sageshoyu/docs-opmanual_sky/README.md

This repository is a duckuments book. 

Please see the repository [docs-duckumentation](https://github.com/duckietown/docs-duckumentation)
for instructions on how to compile this book, and use that repository for filing issues.
