sageshoyu/docs-opmanual_sky/book/opmanual_sky/100-build/101-overview.md

# Build {#part:build status=ready}

This section describes how to build the DuckieSky Drone Version 4. You
will need: 
- a drone kit
- a base station (i.e. personal computer)
- access to a lab, Maker, or Hacker space
- a highly-textured planar surface (e.g. poster board with many random hand-drawn figures)
