sageshoyu/docs-opmanual_sky/(list of files, cad)

Other CAD files:
book/opmanual_sky/100-build/PiMount V2 (1) (1).stl
