sageshoyu/docs-opmanual_sky/book/opmanual_sky/100-build/106-phase1-establish_power_distribution.md

# Establish Power Distribution {#part:build-assignment-5 status=ready}
