sageshoyu/docs-opmanual_sky/book/opmanual_sky/100-build/107-phase2-attach_sensors.md

# Attach Sensors {#part:build-assignment-6 status=ready}
