sageshoyu/docs-opmanual_sky/book/opmanual_sky/100-build/108-phase3-configure_devices.md

# Configure Devices {#part:build-assignment-7 status=ready}
