sageshoyu/docs-opmanual_sky/book/opmanual_sky/100-build/109-phase4-finalize_assembly.md

# Finalize Assembly {#part:build-assignment-8 status=ready}
