sageshoyu/docs-opmanual_sky/book/opmanual_sky/100-build/ESCSetup_DEPREACATED.md

# ESC Setup {status=draft}
The Afro ESC (electronic speed controller) stock firmware is called SimonK. In testing we found that the throttle response time for our ESCs on this firmware was not quick enough, and this would cause adverse flight effects during aggressive maneuvers.

During this step you will reflash your ESCs with an alternative open-source firmware called BLHeli, which is has a faster response time and a convenient GUI for ESC configuration. The BLHeli firmware can only be flashed on Windows. If you do not have Windows, please come to office hours, where we have computers setup to flash BLHeli.

## Flashing ESCs
Make sure you have no propellers on your motors. For each ESC:

1) Plug in the battery to your drone

2) Plug the ESC into the flashing tool. Pay careful attention that the yellow wire goes to s (signal) and the brown wire goes to - (ground).

<figure>
    <figcaption>Plug ESC into Flashing Tool</figcaption>
    
</figure>
<figure>
    <figcaption>Plug ESC into Flashing Tool</figcaption>
    
</figure>

3) Click the "Connect" button in BlHeliSuite
<figure>
    <figcaption>Connect</figcaption>
    
</figure>

4) Click the read setup button
<figure>
    <figcaption>Read Setup</figcaption>
    
</figure>

5) When prompted to flash your ESC, click "Yes"
<figure>
    <figcaption>Flash your ESC</figcaption>
    
</figure>

6) You will be presented with a list of ESC firmwares. Select Afro 20A Multi from the list and click OK.
<figure>
    <figcaption>Select Firmware</figcaption>
    
</figure>

7) Confirm that you want to flash your ESC
<figure>
    <figcaption>Confirm</figcaption>
    
</figure>

<figure>
    <figcaption>Flashing</figcaption>
    
</figure>

8) When finished, a window will appear, notifying you that the ESC has properly been flashed. If there are any errors, call over a TA. Click "OK" to dismiss the window.
<figure>
    <figcaption>Finish Flashing</figcaption>
    
</figure>

9) A window will appear notifying you that the ESC setup has been read successfully. Click "OK".
<figure>
    <figcaption>Done!</figcaption>
    
</figure>

10) Change the "PPM Min Throttle" 1100 and the "PPM Max Throttle" to 1900.
<figure>
    <figcaption>Throttle Config</figcaption>
    
</figure>

If this was one of the motors for which you needed to change the direction in the previous section, change the 'Motor Direction' parameter accordingly.
<figure>
    <figcaption>Correct Motor Directions</figcaption>
    
</figure>

11) Lastly turn off the beacon setting. To do this set it to infinite. This prevents the motors from beeping if the flight controller is plugged in but not receiving controls.
12)
<figure>
    <figcaption>Beacon Setting</figcaption>
    
</figure>

12) Write these changes to the ESC.
<figure>
    <figcaption>Save Changes to ESC</figcaption>
    
</figure>

13) Repeat until all ESCs are flashed.

## Checkoff
Come to TA hours to get checked off! We will check that you have **all four** motors flashed, spinning the right direction, and connected to your flight controller correctly.
