sageshoyu/docs-opmanual_sky/book/opmanual_sky/100-build/FlightControllerSetup_DEPREACATED.md

# Cleanflight on the Skyline 32 {status=draft}

The Skyline 32 is the flight controller; it has an onboard accelerometer and gyroscope, and sends commands to the ESCs. We compile the firmware (called CleanFlight) with an option that allows us to control the Skyline via USB. In this part, you will mount and configure the Skyline 32, install new firmware on it, and power up the motors!

## Mounting the Flight Controller
Plug the voltage monitoring cable (now soldered to your BEC) and the 6-channel PWM cable into your skyline

<figure>
    <figcaption>Plug in Skyline Cables</figcaption>
    
</figure>

Use double-sided foam tape to mount the skyline to the front of your drone. The USB port should be facing forward, so you have access to it. Also run the PWM connectors underneath the pi mount for easier wire management later.

<figure>
    <figcaption>Skyline Top View</figcaption>
    
</figure>

It is very important that the flight controller is perfectly aligned with your drone's frame. Any misalignments will mean that the sensors are getting incorrect (coupled axes) information about the acceleration. Make sure the edge of the flight controller is parallel with the edge of the frame.

<figure>
    <figcaption>Skyline Bottom View</figcaption>
    
</figure>

Carefully plug the 6" USB cable into the USB port of the skyline. These little surface-mount USB micro ports are very prone to failure, so to minimize the likelyhood of ripping off the port or breaking a connection cover the USB connector thoroughly with hot glue. Yes, you will not be able to remove the USB cable. This is intentional.

<figure>
    <figcaption>Glued USB Connector</figcaption>
    
</figure>

## Compiling Firmware For Skyline32
Download the [pre-compiled hex](https://cs.brown.edu/courses/cs1951r/website_2017/projects/build/cleanflight_2.1.0_NAZE.hex).

You can also recompile the firmware. To do this, download the firmware source code at https://github.com/cleanflight/cleanflight and compile with

    make arm_sdk_install

    make NAZE OPTIONS=USE_MSP_UART

## Flashing Fimware
You will now flash the firmware onto the flight controller.

*Note: in order to use cleanflight on your personal computer rather than base station in the lab see cleanflight homepage for driver installation.*

1. Plug the skyline into the computer via USB. If your skyline is already on a drone, do not connect the battery.
2. Open [cleanflight configurator](https://chrome.google.com/webstore/detail/cleanflight-configurator/enacoimjcgeinfnnnpajinjgmkahmfgb) and go to the "Firmware Flasher" tab. This tab is before you connect to the base station.

<figure>
    <figcaption>Firmware Flasher</figcaption>
    
</figure>

3. Click "Load Firmware [local]" and load your custom firmware file.

<figure>
    <figcaption>Load Firmware</figcaption>
    
</figure>

4. Click the "Flash Firmware" button to flash the flight controller.

<figure>
    <figcaption>Flash Firmware</figcaption>
    
</figure>

5. If this is a success, the bar at the bottom will say "Programming: SUCCESSFUL" and you are ready to move to the next step.
<figure>
    <figcaption>Success!</figcaption>
    
</figure>

## Configuration Options
You will configure the flight controller based on our drone's specific geometry and hardware.

1. Plug in Skyline and click "Connect"
<figure>
    <figcaption>Connect to Skyline</figcaption>
    
</figure>
2. Go to "Ports" tab and make sure SerialRX for UART2 is disabled and click "Save and Reboot." UART2 is a pin on the flight controller, and we want to make sure it only uses the USB.
<figure>
    <figcaption>Ports Config</figcaption>
    
</figure>

3. Go to "Configuration" tab
4.
i. Flip the yaw by 180 degrees and click "Save and Reboot." This is because we mount the flight controller the opposite direction in order to leave the USB port free to plug into the Raspberry Pi.
<figure>
    <figcaption>Flip Yaw</figcaption>
    
</figure>
ii. Also change the receiver to "MSP RX input" and click "Save and Reboot." By default it is configured to receive data from an RC receiver, but we want it to take commands over MSP.
<figure>
    <figcaption>MSP RX Input</figcaption>
    
</figure>
iii. Set the Minimum Throttle to 1100.
4. We need tell it to be in Angle mode for the entire range (and not acrobatic mode). Go to the "Modes" tab
i. Under "Angle", click "Add Range."
<figure>
    <figcaption>Angle Mode</figcaption>
    
</figure>
ii. Drag the sliders so that the range spans from 900 to 2100. (The entire range.)
<figure>
    <figcaption>Expand Range</figcaption>
    
</figure>
<figure>
    <figcaption>Expanded Angle Range</figcaption>
    
</figure>

iii. Click "Save".

5.We need to change the PID parameters to ones that work better on our drone. Go to the "PID Tuning" tab.
i. Change the "ROLL" and "PITCH" PID terms to match the image. Roll should be (Proportional: 60, Integral: 40, Derivative: 50, RC Rate: 1.00, Super Rate: 0.00, Max Vel: 200). Pitch should be (Proportional: 60, Integral: 40, Derivative: 50, RC Rate: curly bracket, Super Rate: 0.00, Max Vel: 200)
<figure>
    <figcaption>PID Params</figcaption>
    
</figure>
ii. Change angle limit to 50.
<figure>
    <figcaption>Angle Limit</figcaption>
    
</figure>
iii. Click "Save."

## Plug in the motors
The numbers corresponding to each motor are as shown. Recall that the camera is in the back of the frame and the flight controller is in the front.
<figure>
    <figcaption>Motor Numbers</figcaption>
    
</figure>
The yellow cable coming out of the skyline has 6 numbered connectors. Plug each motor into the corresponding connector (1-4) according to the above numbering scheme. The connectors shouldn't be too easy to plug in backwards, but make sure the yellow wire from the motor goes to the yellow wire in the connector from the skyline. The other 2 wires PWM 5/6 can be cut off.
<figure>
    <figcaption>Connecting PWM Wires</figcaption>
    
</figure>

## Test the motors
This is the first time you will be firing up your drone! At this point, make sure there is nothing that could be potentially causing a short on your PDB. Take a battery and plug it into the XT60 connector. If you did everything right, lights should come on and the motors beep. If this doesn’t happen, unplug the battery **immediately**! It is likely the case that something is backwards or shorting, and you could be causing damage by applying a voltage.

Now plug in the Skyline to your computer via USB and connect to the Cleanflight configurator.

i. Go to the Motors tab in Cleanflight. Make sure the props are off!
ii. Read the safety notice and check the box that says “I understand the risks, propellers are removed - Enable motor control.”
iii. Slowly power up each motor. Verify first that the correct motor spins and second that it spins in the correct direction using the diagram below.
iv. If the motor does not spin, verify the connections, make sure there are no shorts and that it has power.
v. If the motor spins in the wrong direction, make a note of which motor it is. You will be able to flip the directions of motors that are spinning the wrong way in the next section.

<figure>
    <figcaption>Correct Motor Directions</figcaption>
    
</figure>

## Calibrate your ESCs

This configuration tells the ESC at what PWM to start spinning up the
motor.  If you do not do it, the ESCs will not all work together to
allow the drone to fly stably.  Symptons that this needs to be done
include hot motors, a drone that lists to one side, or motors that
appear to spin at different speeds.

There appears to be a software bug in Cleanflight that causes this
calibration process to switch the motor directions, so make sure you
follow all steps and make sure the motors are spinning in the right
direction when you finish.

1. REMOVE ALL PROPELLERS.
1. Connect the flight controller to computer, then open up CleanFlight.
1. Go to Motors tab.
1. Unplug the battery from the drone.
1. Toggle on "Motor Test Mode Notice". MAKE SURE ALL PROPELLERS REMOVED!
1. Drag master slider up to full. All 4 motor sliders should move up to full accordingly (i.e. 2000).
1. Plug the battery into the drone
1. ESCs will make an interesting set of sounds, kind of like music.  If they do not, stop and try the previous steps again.
1. After the music stops, click on the bottom end of the master slider bar. The master slider should now be at the bottom of the bar. Correspondingly, all 4 motor sliders should be at the bottoms of their bars (i.e. 1000).
1.. The motors will make another set of sounds. 
1. After the sounds stop, spin up each motor one at a time. Make sure they are spinning in the right direction (i.e. according to the diagram).  
1. Go to the Configuration tab. If the drone diagram is yellow and says "reversed", then toggle the "direction" slider below it to undo the reverse. The diagram should now be green, with each motor in the diagram having the expected spin direction. Click "save and reboot".
1. Unplug from CleanFlight, reconnect everything to the drone, and
power it on. MAKE SURE THE PROPELLERS ARE REMOVED. Arm the drone and
make sure each motor is spinning in the desired direction
(i.e. according to the green diagram).
