sageshoyu/docs-opmanual_sky/book/opmanual_sky/100-build/IRsensor_DEPREACATED.md

# Sharp Infrared Range Finder {status=draft}
The Sharp IR sensor shoots out an infrared beam and measures distance by the angle at which that infrared light is bounced back.

It is an analog sensor, which means that it outputs a range of voltages to indicate its measurement, as opposed to a digital signal (1s and 0s). Unfortunately, the Raspberry Pi 3 does not have any way to read analog values, so we need a device to convert the analog voltage to a digital signal we can make sense of...

Enter the Analog to Digital Converter (ADC)!

<figure>
    <figcaption>ADC</figcaption>
    
</figure>

This nifty little device can read four analog signals (A0 - A4) and outputs a digital protocol (i2c) which the Pi can read through it's general purpose digital input/output (GPIO) pins.

## Pi Hat!
You'll be soldering the ADC to the Pi Hat, which provides breadboard like functionality (meaning that pins in the same row of the Pi Hat are all connected). The Pi Hat makes makes soldering and wiring the ADC to the Pi's GPIO pins far easier and neater.
<figure>
    <figcaption>Pi Hat</figcaption>
    
</figure>

1. Solder the header pins to ADC.
<figure>
    <figcaption>ADC Pins</figcaption>
    
</figure>

<figure>
    <figcaption>Soldered ADC Pins</figcaption>
    
</figure>

2. Solder the  Pi header to the Pi hat.

<figure>
    <figcaption>Back of Pi Hat</figcaption>
    
</figure>

<figure>
    <figcaption>Soldered Hat</figcaption>
    
</figure>

3. Solder ADC to Pi Hat in this position on the board

<figure>
    <figcaption>ADC Soldered to Pi Hat</figcaption>
    
</figure>

4. Take your infrared connector cable and cut the black connector off to expose the wire ends. Strip and tin the exposed wires.

<figure>
    <figcaption>Cut IR Wire</figcaption>
    
</figure>

5. Cut and strip red, yellow, green, and black 24 AWG stranded wires to fit where shown.
##### Wiring diagram

<figure>
    <figcaption>Pi Hat Wiring</figcaption>
    
</figure>

What it should look like.

<figure>
    <figcaption>Finished Pi Hat</figcaption>
    
</figure>

**Note:** The IR sensor wires are quite weak and need to be stripped carefully and soldered securely to prevent them from breaking during flight.
