sageshoyu/docs-opmanual_sky/book/opmanual_sky/10-build/90-Connect.md

# Set Up your Base Station {#build-assignment-8 status=ready}

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

## Connect to the Drone
Power up your drone and connect to its wifi network, `defaultdrone`. The wifi password is bigbubba. Once connected, `ssh pi@defaultdrone.local`. (Or figure out the IP address from route; see the networking assignment.) The password is `bigbubba`.

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

Change the hostname with sudo raspi-config. (This is important because you want to know if you connect to the wrong drone.) Change the wifi SSID by editing `/etc/hostapd/hostapd.conf`. Reboot after these changes by running `sudo reboot`.

## Get the repo
There are two ways to get a copy of our solution code off of github and onto your drone. The first way is to use git clone to clone the repo onto your drone, but your drone will need to be connected to the wifi. If you are a Brown student, this is made possible if you are in the CIT or the SciLi by following these instruction below. The other alternative is to just download and unzip the repo onto your base station and using the command: `scp -r [filepathToFileOnYourComputer] pi@[yourDronesHostname]:~/ws/src/` to copy the files to your drone. After doing this, ssh into your drone and skip to step 3 below.
To use git clone, you'll need to connect your drone to the internet. We've included a script, `~/cs1951r_utils/connect_to_rlab.py` that will disable your wifi access point and connect to the RLAB network. It will reset to the access point after a reboot.

1. Run connect_to_rlab.py, and then connect your basestation to RLAB wifi (password: metropolis) You should be able to ping your drone with `ping pi@hostname` where hostname is whatever you set it to in the previous step. If this does not work, try using `nmap` to find your drone. When doing this be very sure you are connected to your drone. (Blink the power LED to be sure.)

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

<code>&#96;</code>0: roscore (enables ROS nodes to communicate)
<code>&#96;</code>1: mode_controller.py (controls whether drone is disarmed, armed, or flying)
<code>&#96;</code>2: command_line_interface.py (enables user to send flight commands to the drone through the command line)
<code>&#96;</code>3: flight_controller_node.py (sends flight commands to the flight controller)
<code>&#96;</code>4: pid_controller.py (runs a PID controller for the drone to autonomously control its motion)
<code>&#96;</code>5: state_estimator.py (publishes the estimated state of the drone)
<code>&#96;</code>6: vision_flow_and_phase.py (enables the pi camera to start recording)
<code>&#96;</code>7: infrared_pub.py (publishes height readings from the infrared sensor)
<code>&#96;</code>8: rosbridge (allows the Javascript interface to connect to the drone)
<code>&#96;</code>9: web_video_server (the python program that serves camera images as an image stream for the web)
If roscore fails to start, you will need to restart all of the other programs once you get it running. Sometimes roscore starts "half way" and leaves a zombie process running. If it won't start, run ps -elf | grep ros and kill any roscore or rosmaster processes and try again. You know it has started correctly when you see it print the ROS_MASTER_URI.

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

1) Without running a heartbeat on the drone and with the web interface connected: Arm the drone, then close the web window. Verify the drone automatically disarms after 5 seconds.
2) Without running a heartbeat on the drone and with the web interface connected: Arm the drone, then disconnect from the drone wifi. Verify the drone automatically disarms after 3 seconds.
3) Publish the heart beat with the rostopic pub command above. What happens now when you disconnect the Wifi? Why? (Make sure your props are off when doing this test!)
As soon as there are propellors on your drone **NEVER** run the heartbeat message locally.

## Checkoff
Show your drone to a TA with each part of the UI working. They will verify that 1) the IR sensor is working 2) the camera is sending data 3) arm/disarm works and 4) the heartbeat safety mechanism works on wifi dropouts.

They will then show you how to fly.
