sageshoyu/docs-opmanual_sky/book/opmanual_sky/10-build/05-build_intro.md

# Introduction {#build-intro status=ready}

The goal of this project is to build your drone and test it with the solution code. Parts necessary for the build are provided in your kit. In addition, you will need a base station (i.e. personal computer) in order to control the drone.

## Base Station
You will need a base station to connect to the drone and give it commands. Any Mac, GNU/Linux, or Windows OS will be sufficient. If you are a Brown student taking the course and do not have such a basestation, talk to us and we will provide one that you can borrow for the semester.

## Where to work
Please ask the TAs about where to work and when.

## Checkoff
Throughout the project are checkoff points where you will come show us your drone. You can come to office hours to get checked off, and we will also provide special lab hours for checkoff and help with the project.

We will check the following things:

  * Solder joins. (Shorts? Mechanical failure?)
  * Motors are correct orientation.
  * Camera in the right spot.
  * IR in the right spot.
