sageshoyu/docs-opmanual_sky/book/opmanual_sky/10-build/60-Additional-Resources.md

# Additional Resources {#build-additional-resources status=ready}

Here is a list of resources that you might find useful as you work on your drone. Some of these resources elaborate on concepts that we gloss over in this course but that you might find interesting, namely related to hardware.

- Beginner soldering tutorial ([YouTube video](https://www.youtube.com/watch?v=Qps9woUGkvI))
- Basics of electrical circuits and $V=IR$ ([SparkFun article](https://learn.sparkfun.com/tutorials/voltage-current-resistance-and-ohms-law))
- Troubleshooting loading firmware on flghtcontroller ([Skyline 32 1.1 Manual](http://yinyanmodel.com/user%20manual%20for%20skyline32%20flight%20controller.pdf))
