sageshoyu/docs-opmanual_sky/book/opmanual_sky/00-index.md

# Duckiedrone Operations Manual {#book:opmanual_duckiedrone status=ready}

Maintainer: Stefanie Tellex

This book is the operations manual for the Duckie Drone.
