sageshoyu/docs-opmanual_sky/book/opmanual_sky/100-build/110-phase5-fly_the_drone.md

# Fly the Drone {#part:build-assignment-9 status=ready}
