sageshoyu/docs-opmanual_sky/book/opmanual_sky/10-build/phase_0_photos/right_xt60_front.JPG

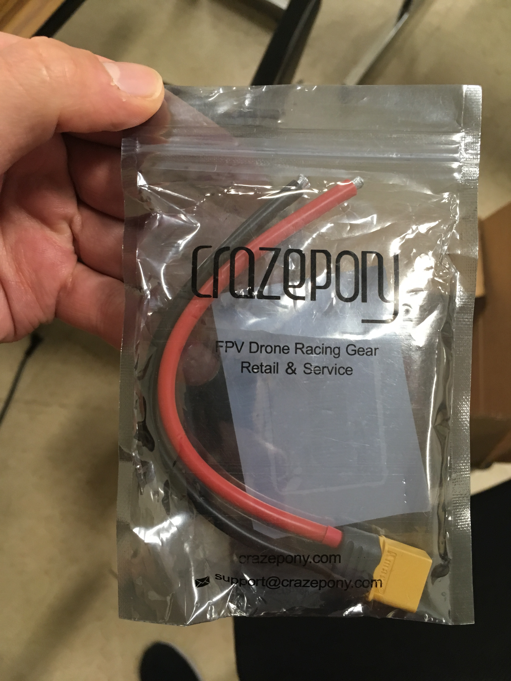
book/opmanual_sky/10-build/phase_0_photos/right_xt60_front.JPG
