sageshoyu/docs-opmanual_sky/book/opmanual_sky/100-build/111-Troubleshooting.md

# Troubleshooting {#part:build-assignment-10 status=ready}

- Help, I accidentally cut off a chunk of my wire while stripping!

  Grab another wire of the same color, then strip and tin it on one end. Solder this new wire to your original wire. Cover the solder joint with either a heat shrink or electrical tape.
  
- Help, I cut off several strands of wire while stripping!

  If you cut off just a couple of strands, then the wire is probably still safe to use. If you cut off a large percentage of strands, then you will need to get a new wire.

- Help, I put too much solder on my wire while tinning!

  The easiest way to remove excess solder is to use a solder sucker or copper wick. Alternatively, excess solder can be removed by carefully picking up the excess with a soldering iron, then cleaning the soldering iron with soldering wool. Repeat as needed.

- Help, my wire is picking up random particles while tinning!

  Clean the tip of your soldering iron with soldering wool. For future prevention, do this cleaning more frequently while soldering.

- Help, the alligator clips of my helping hands are loose!

  Remove the offending alligator clip from the helping hands, then use pliers to carefully pinch the end tighter. Re-insert once fit is tight.

- Help, I burned some insulator onto my wire while tinning!

  A little bit of insulator burn is probably fine. If a lot has been burned, use a wire cutter to carefully cut off the burned parts. If that fails, you will need another wire.

- Help, I can't tell if I tinned my wire properly!

  Use a wire cutter to cut off the tip of the tinned wire. Visually inspect the core. If solder is not in the core or if the wire strands can be spread with your fingers, then the wire is not tinned properly.

- Help, my solder keeps melting into a sphere shape instead of melting onto a wire!

  This happens because the solder is not getting hot enough to fully melt. This could be a consequence of: 1) the soldering iron tip has reached the end of its life, 2) the solder has expired, or 3) the soldering iron station no longer works properly. Systematic debugging is required to determine the cause, preferably in the order listed. When the culprit part is determined, replace with a new one.
