sageshoyu/docs-opmanual_sky/(commit log)

2018-09-04 Rename 06- ESC Setup (1).md to 06- ESC Setup .md
2018-10-09 Made a note about battery monitor lead
2018-11-16 updated instructions and calibrating esc
2019-04-08 Update 30-partsList.md
    added pi mount stl link like other www. links
2019-09-01 [#1] Created "stripping and tinning wires" section
2019-09-01 [#1] Created section on creating a XT60 connector cable
2019-09-01 [#1] Corrected mistake about soldering fumes
2019-09-02 [#1] Completed "soldering ESC pads" section
2019-09-02 [#1] Did another pass of editing
    cleaned up and clarified a good amount of stuff. Also linked to a "tinning and joining wires" tutorial.
2019-09-02 [#9] Update Parts List Document
    need picture for screws_silver/bullet_connector
2019-09-02 [#9] Upload adc.png to Photo Folder
2019-09-02 [#9] Update the Filename for Pi Mount Picture
    from pimount.jpg to pi_mount.jpg
2019-09-02 [#9] Update Line Switch and Bullet Connector
    Update the description of bullet connectors
2019-09-02 [#9] Upload standoffs_with_screws.png
2019-09-02 [#9] Update M3 Bolts (Black Screws)
    Update description, move it next to standoffs part and change picture from black_screws.jpg to standoffs_with_screws.png.
2019-09-03 [#9] Add Materials List Words
    Add heat shrinks and zip ties to Materials List Words
2019-09-03 [#1] Added xt60 connector photo
2019-09-04 [#13] Correct typo in AC voltage check section
2019-09-04 [#2] Added warning about which side of BEC to solder to PDB. Also added visual inspection to checkoff.
2019-09-04 [#2] Added section on battery monitor lead
2019-09-04 [#1] Added "solder bullet connector" section
    Bumped up the expected time accordingly
2019-09-04 [#1] Switched order of checkoff items
2019-09-04 [#2] Added section on soldering XT60 connector cable to PDB
2019-09-04 [#2] Added section on attaching items to drone frame
    Updated checkoff accordingly
2019-09-04 [#1] Look cleanup
    before "Solder wires onto ESC pads"
2019-09-04 [#1] Added new tinned wire photos
2019-09-04 [#1] Changed the tinned wire photos
2019-09-04 [#1] Removed new tinned wire photos so I can re-upload via github.com
2019-09-04 [#1] Re-uploading new tinned wire photos
    doing this because it only seems to work through github.com
2019-09-04 [#8] Added line about difference between wires
2019-09-04 [#8] Uploaded Philips Screw Driver Image
2019-09-04 [#9] Upload Heat Shrink Photo
2019-09-04 [#8] Added image of Philips screw driver in the equipment list page
2019-09-04 [#9] Upload Silver Screws Photo
2019-09-04 [#2] Upload Power Flow Photo
2019-09-04 [#9] Added photo of red motors
2019-09-04 [#9] Changed motors photo to red motors
2019-09-04 [#9] Upload New Pi Mount Photo
2019-09-05 [#2] Changed velcro direction and name of black screws
2019-09-05 [#8] Added new wire photo
2019-09-05 [#8] Fixed esc wire photo
2019-09-05 [#9] Added charge adapter photo
2019-09-05 [#9] Collapsed sensors with their wires
2019-09-05 [#9] Tried to make camera heading into one line
2019-09-05 [#1] Removed note about excess solder
2019-09-05 [#1] Added photo of ABC pads on ESC
2019-09-05 [#1] Added ESC pad letters photo
2019-09-05 [#18] Removed IR sensor from build assignment
2019-09-05 [#18] Tried yet again to make numbering work out
    [PiMount V2 (1) (1).stl]
2019-09-05 [#2] Update Photo Size
    Remove all the conflicting attributes and set all pictures with width="400" except photos/standoffs_with_screws.png with width="200"
2019-09-05 [#18] Renumberd files again
    [PiMount V2 (1) (1).stl]
2019-09-06 [#2] Added non-LFS-uploaded files because sourcetree is complaining
    [PiMount V2 (1) (1).stl]
2019-09-06 [#27] Added missing standoffs pic
